PnMagalhaes/uRato_Minotauro/Poster/escorpiao.jpg

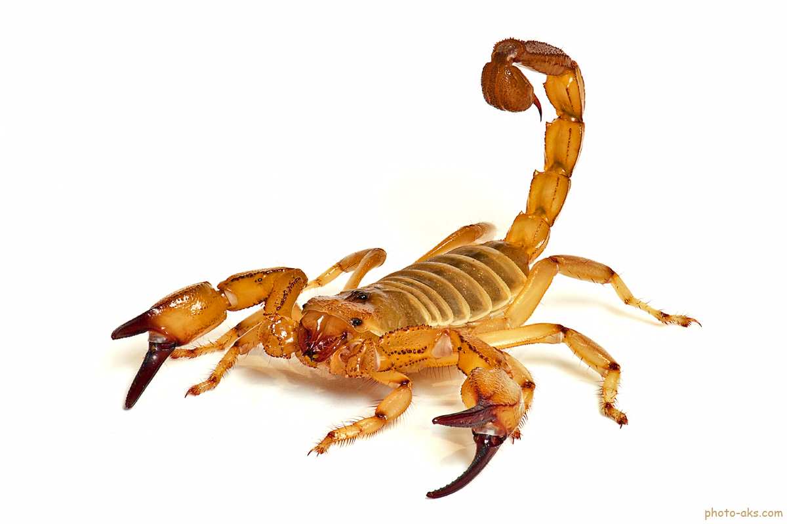
Poster/escorpiao.jpg
