PnMagalhaes/uRato_Minotauro/Gallery/IMG_20180509_173940.jpg

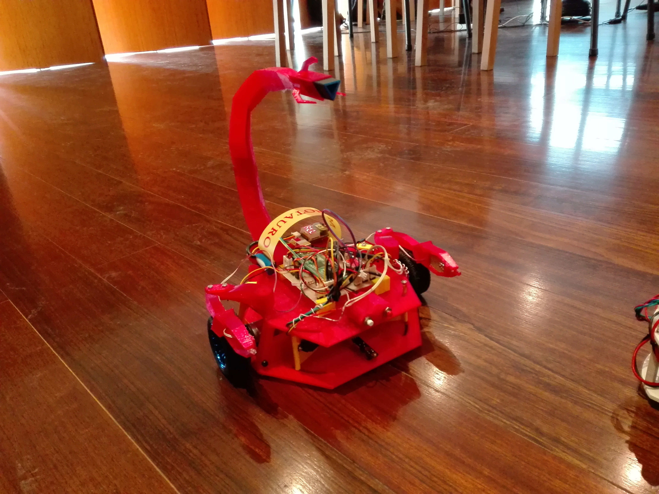
Gallery/IMG_20180509_173940.jpg
