PnMagalhaes/uRato_Minotauro/README.md

# uRato_Minotauro
Maze runner competition
