PnMagalhaes/uRato_Minotauro/CAD/servo/Servo S05NF.JPG

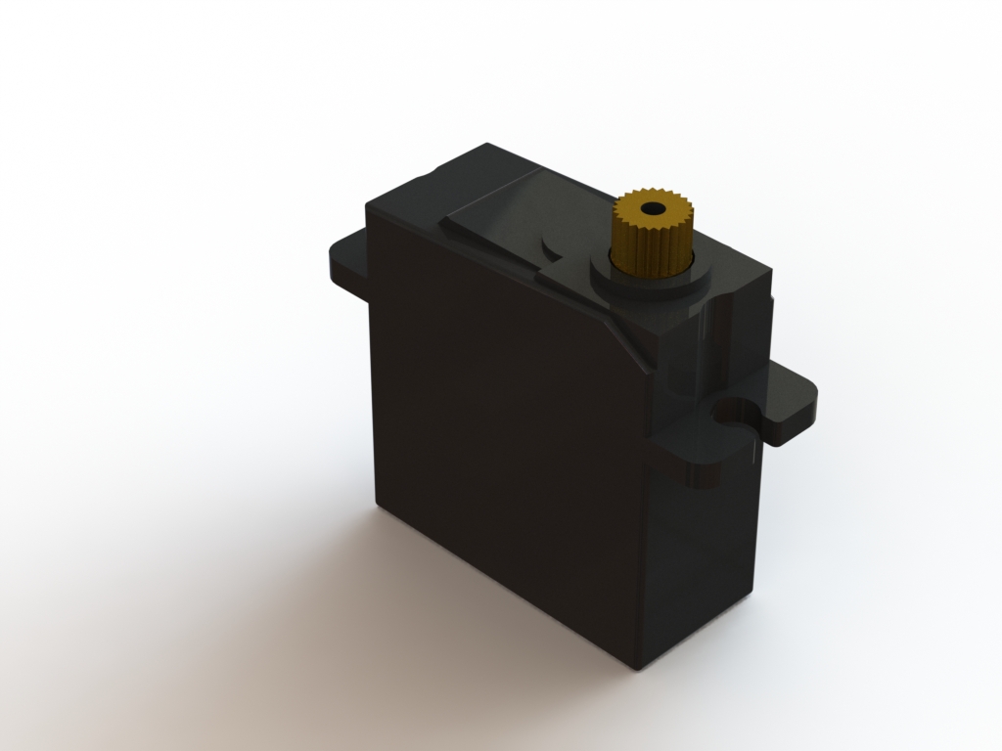
CAD/servo/Servo S05NF.JPG
