PnMagalhaes/uRato_Minotauro/CAD/wheel-with-tire/Renderings/tyre.JPG

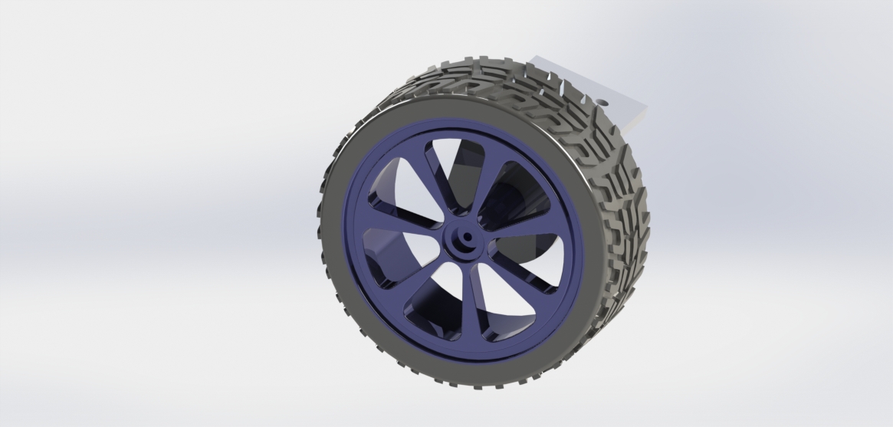
CAD/wheel-with-tire/Renderings/tyre.JPG
