PnMagalhaes/uRato_Minotauro/CAD/wheel-with-tire/Renderings/Wheel_With_Motor.png

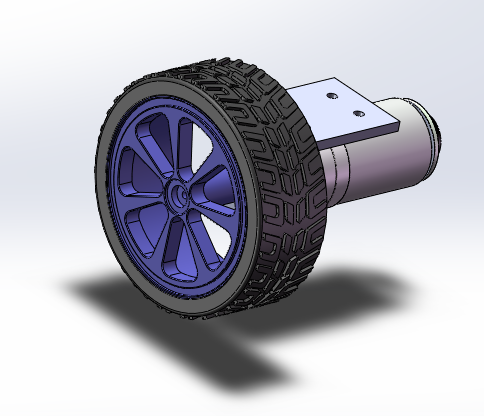
CAD/wheel-with-tire/Renderings/Wheel_With_Motor.png
