PnMagalhaes/uRato_Minotauro/Poster/brain.png

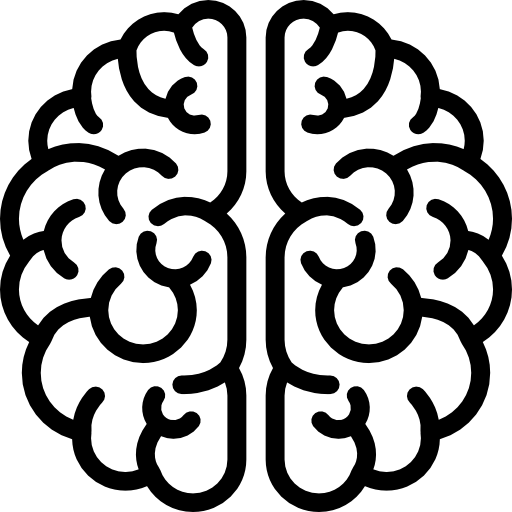
Poster/brain.png
