PnMagalhaes/uRato_Minotauro/Poster/integrated-circuit.png

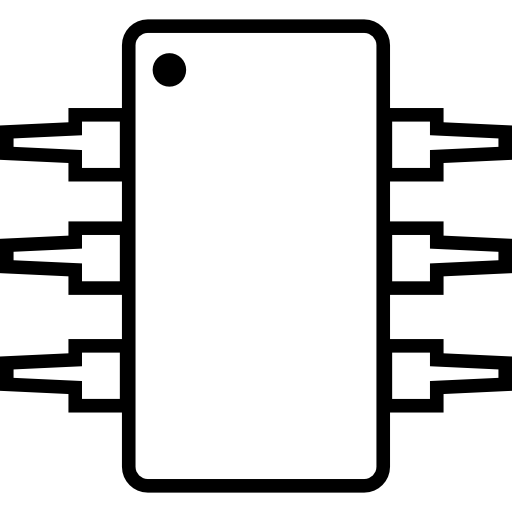
Poster/integrated-circuit.png
