PnMagalhaes/uRato_Minotauro/Poster/square-grid.png

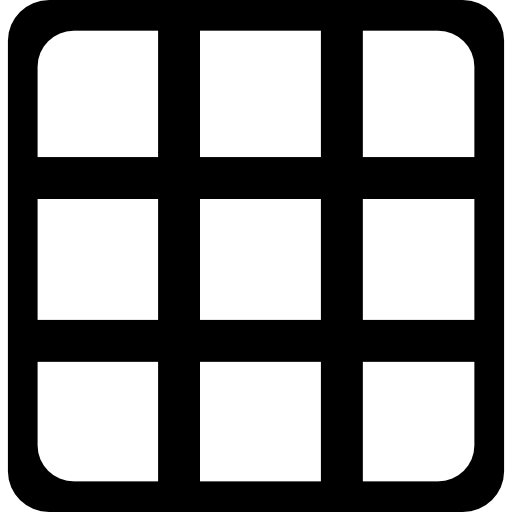
Poster/square-grid.png
