PnMagalhaes/uRato_Minotauro/Poster/wind-rose.png

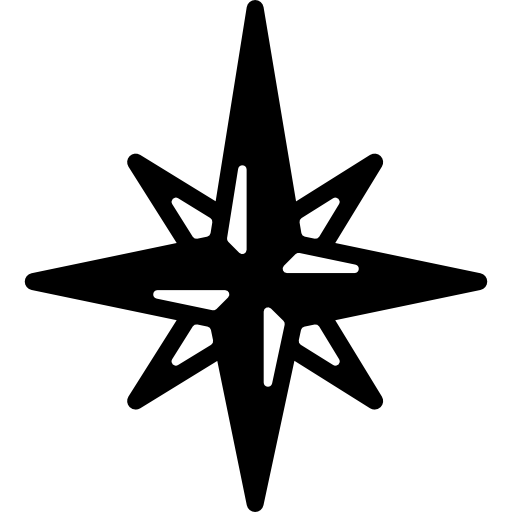
Poster/wind-rose.png
