PnMagalhaes/uRato_Minotauro/CAD/Assem1.SLDASM

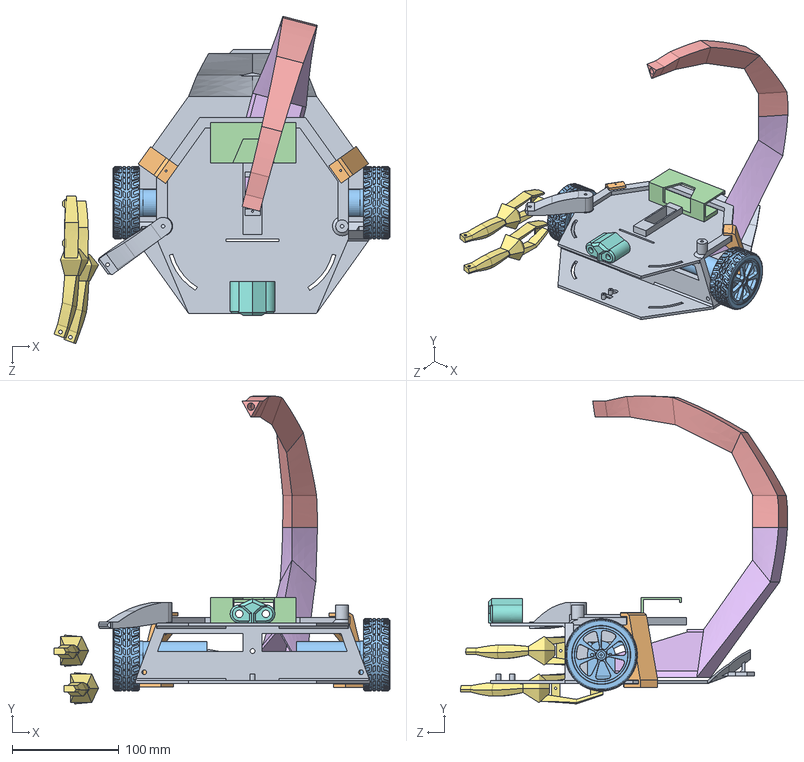
[picture p10: CAD file, 2018-05-11]
CAD/Assem1.SLDASM
315.4 x 289.0 x 307.3 mm
Base
base_reforço x 2
Ass_Motor x 2
bat_holder
cauda_1
Cauda_2
garra x 2
head
patinha
