PnMagalhaes/uRato_Minotauro/CAD/wheel-with-tire/Renderings/Wheel Assemble.SLDASM

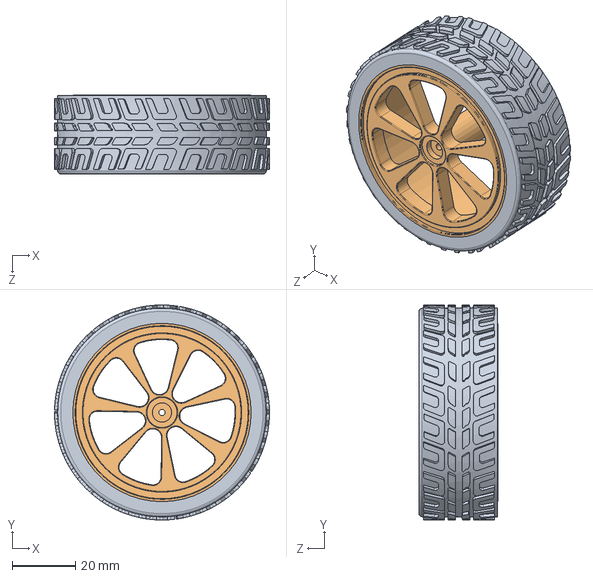
[picture p11: CAD file, 2018-05-04]
CAD/wheel-with-tire/Renderings/Wheel Assemble.SLDASM
68.0 x 68.0 x 25.0 mm
Tire
WheelFrame
