PnMagalhaes/uRato_Minotauro/CAD/Total.SLDASM

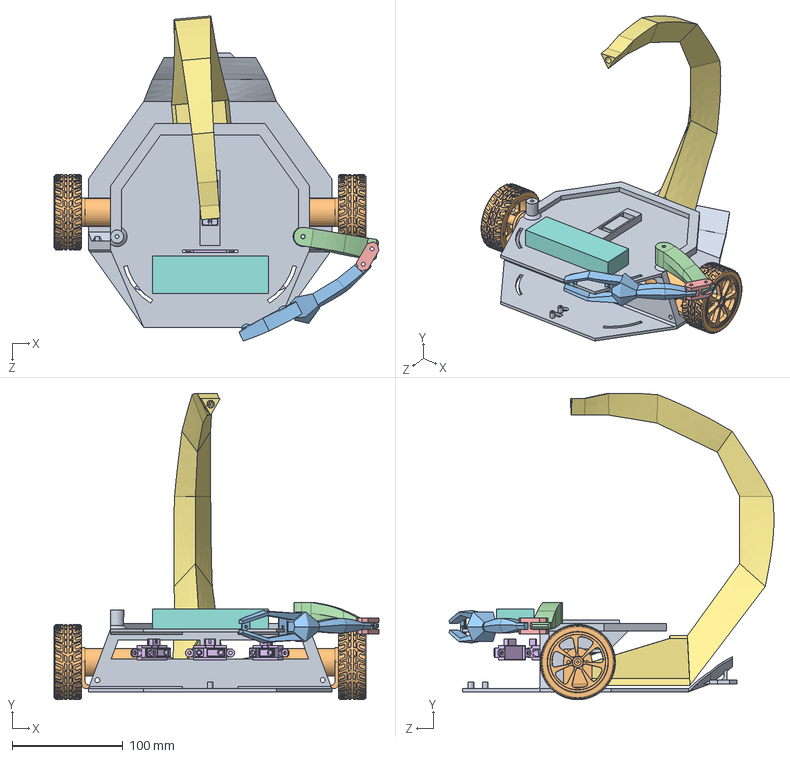
[picture p12: CAD file, 2018-05-04]
CAD/Total.SLDASM
293.6 x 276.9 x 293.7 mm
Base
Ass_Motor x 2
garra
patinha
união
Long Range SHARP IR Sensors - #GP2Y0A21YK0F x 3
cauda
bateria
Servo S05NF
