PnMagalhaes/uRato_Minotauro/CAD/Ass_cauda.SLDASM

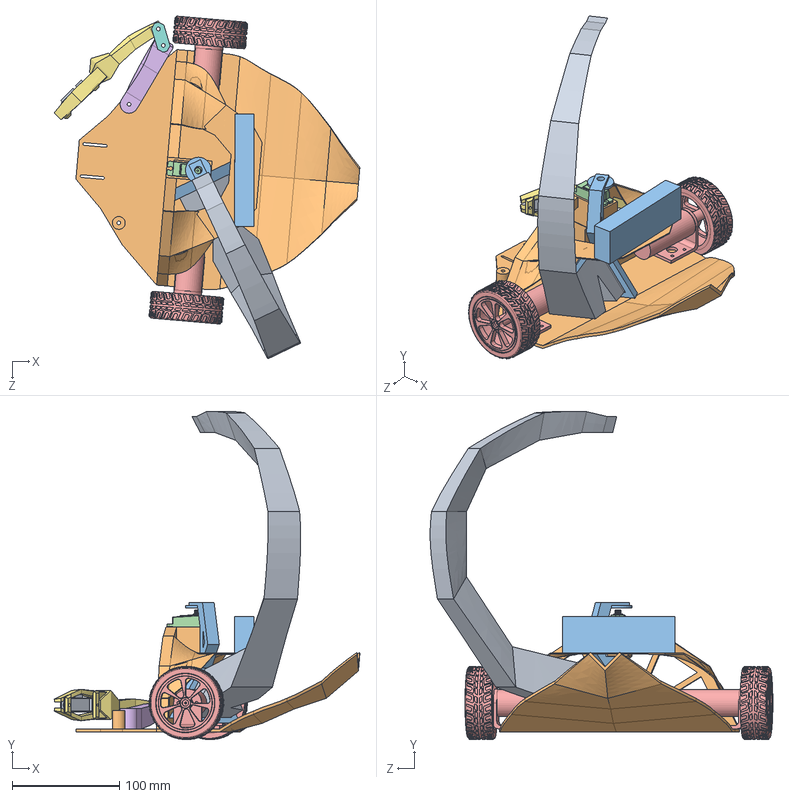
[picture p13: CAD file, 2018-05-04]
CAD/Ass_cauda.SLDASM
284.5 x 305.2 x 318.9 mm
cauda
cauda_3
cauda_encaixe
Servo S05NF
Ass_Motor x 2
patinha
garra
união
Long Range SHARP IR Sensors - #GP2Y0A21YK0F
topcoverback
bateria
