PnMagalhaes/uRato_Minotauro/CAD/Assem2.SLDASM

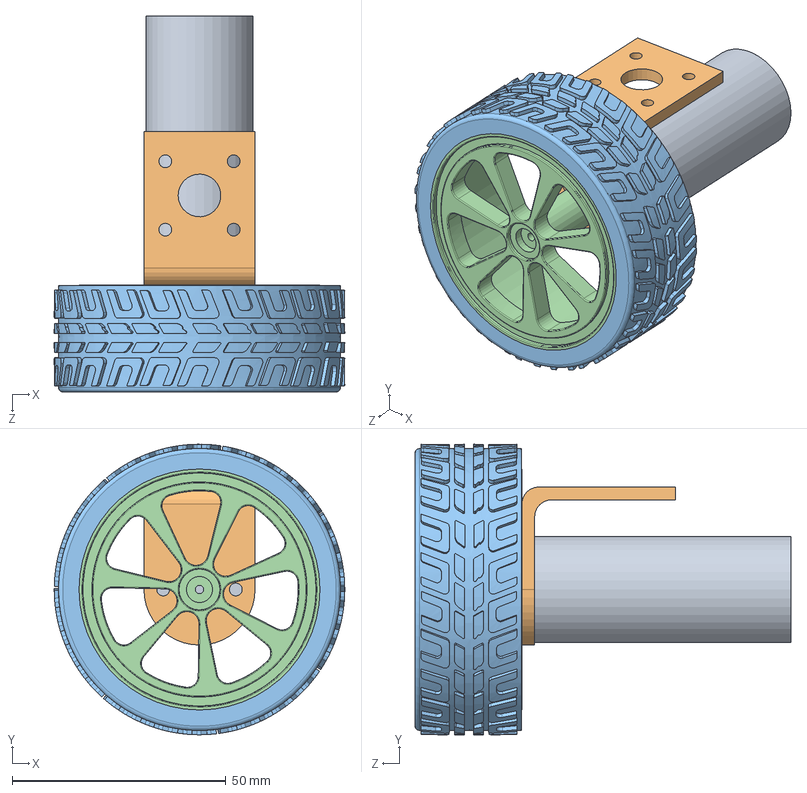
[picture p14: CAD file, 2018-05-04]
CAD/Assem2.SLDASM
68.0 x 68.0 x 88.0 mm
motor
bracket
Tire
WheelFrame
