PnMagalhaes/uRato_Minotauro/CAD/_STL/base_reforco.STL

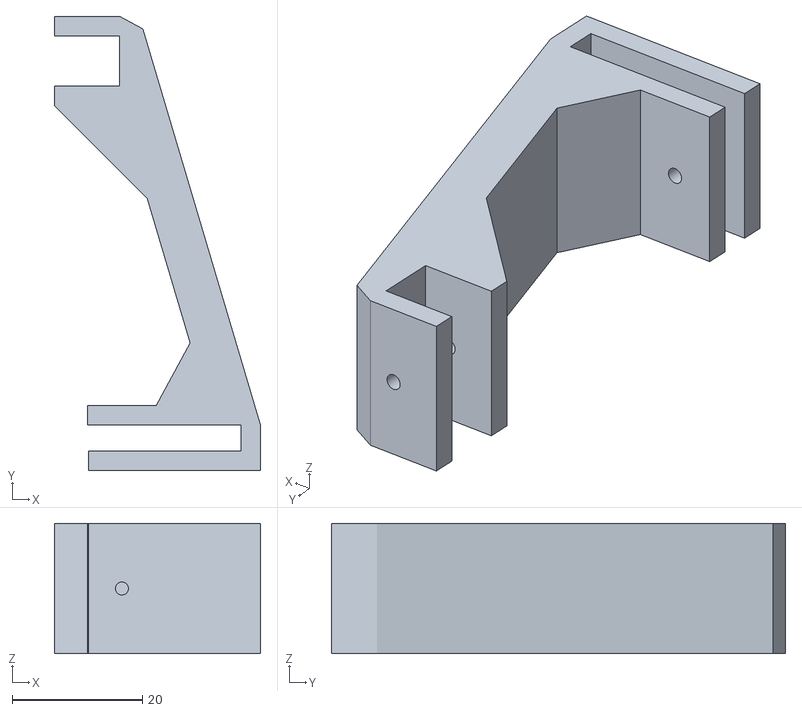
[picture p15: CAD file, 2018-05-11]
CAD/_STL/base_reforco.STL
31.6 x 69.7 x 20.0
