PnMagalhaes/uRato_Minotauro/CAD/wheel-with-tire/motor.SLDPRT

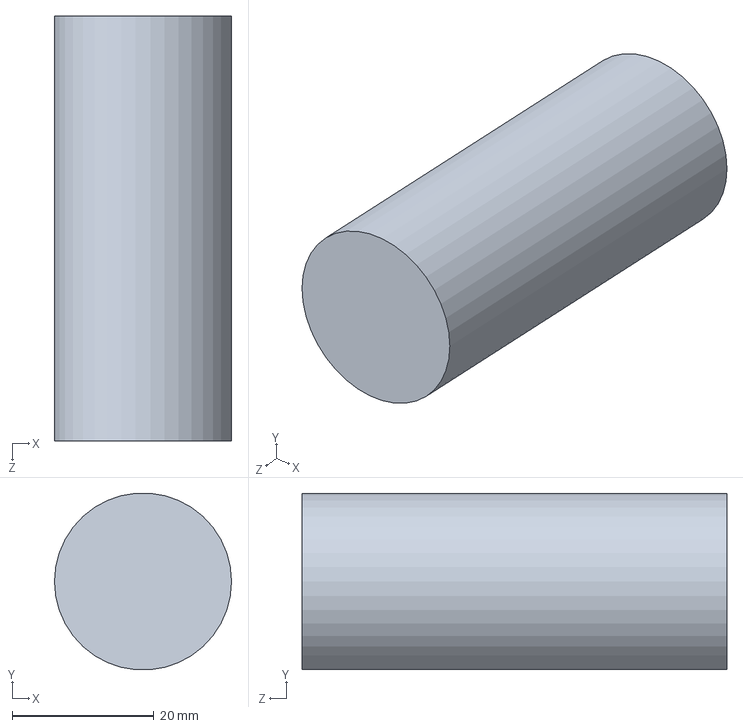
[picture p16: CAD file, 2018-05-04]
CAD/wheel-with-tire/motor.SLDPRT
25.0 x 24.9 x 60.0 mm
