PnMagalhaes/uRato_Minotauro/CAD/wheel-with-tire/Renderings/bracket.SLDPRT

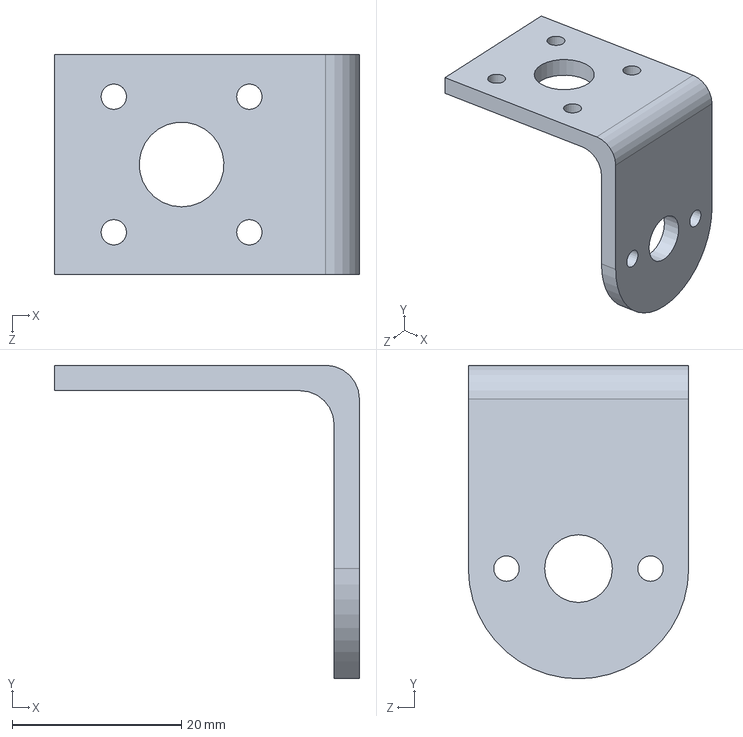
[picture p17: CAD file, 2018-05-04]
CAD/wheel-with-tire/Renderings/bracket.SLDPRT
36.0 x 37.0 x 26.0 mm
