PnMagalhaes/uRato_Minotauro/CAD/_STL/cauda_anilha2.STL

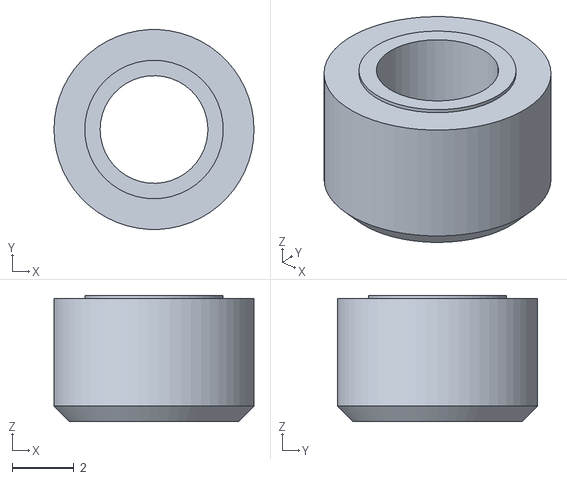
[picture p18: CAD file, 2018-05-04]
CAD/_STL/cauda_anilha2.STL
6.50 x 6.49 x 4.10
