PnMagalhaes/uRato_Minotauro/CAD/_STL/base_tras.sldprt

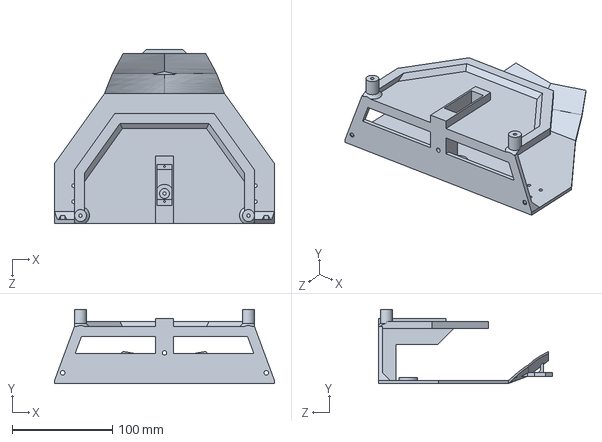
[picture p19: CAD file, 2018-05-04]
CAD/_STL/base_tras.sldprt
220.0 x 74.0 x 174.1 mm
