PnMagalhaes/uRato_Minotauro/CAD/cauda_join.SLDPRT

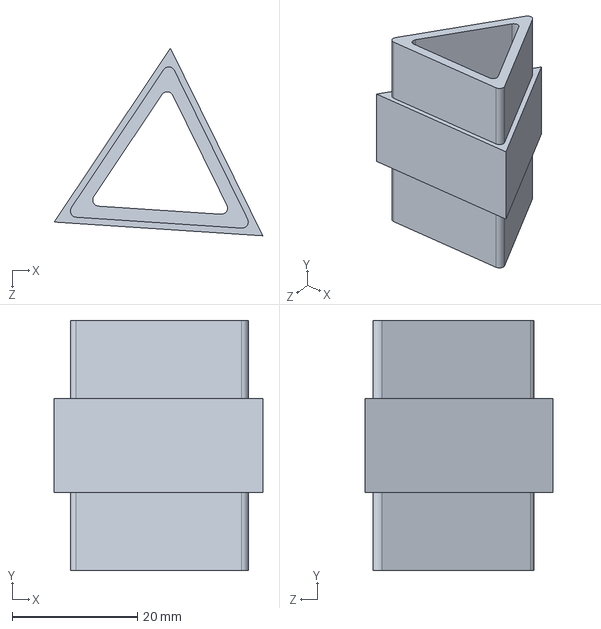
[picture p20: CAD file, 2018-05-11]
CAD/cauda_join.SLDPRT
33.4 x 40.0 x 30.0 mm
