PnMagalhaes/uRato_Minotauro/CAD/wheel-with-tire/Renderings/Tire.SLDPRT

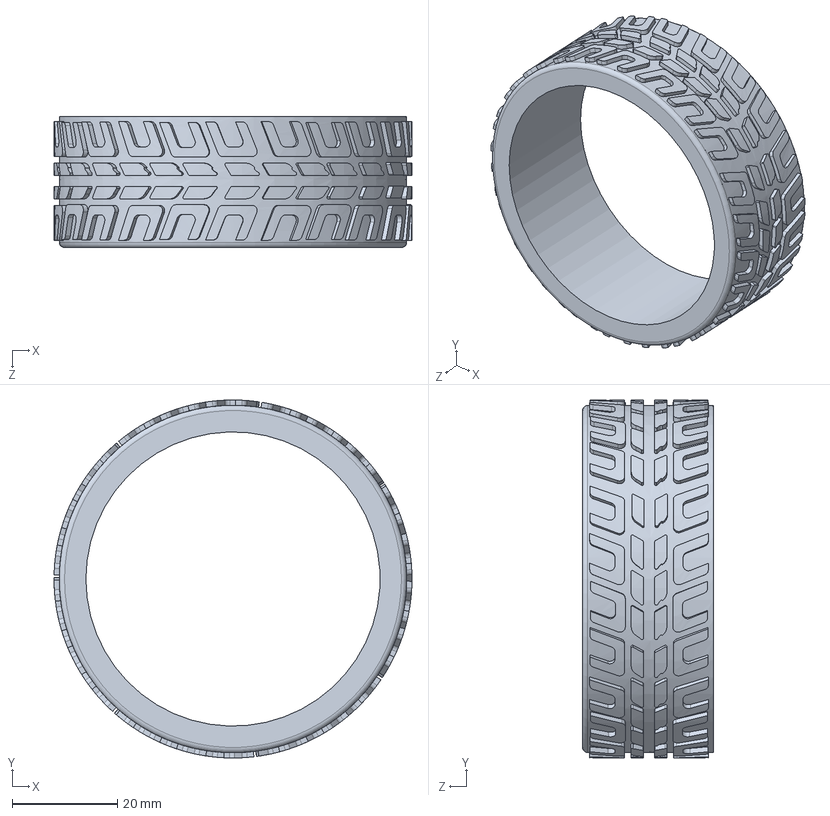
[picture p21: CAD file, 2018-05-04]
CAD/wheel-with-tire/Renderings/Tire.SLDPRT
68.0 x 68.0 x 24.9 mm
