PnMagalhaes/uRato_Minotauro/CAD/lapide.SLDPRT

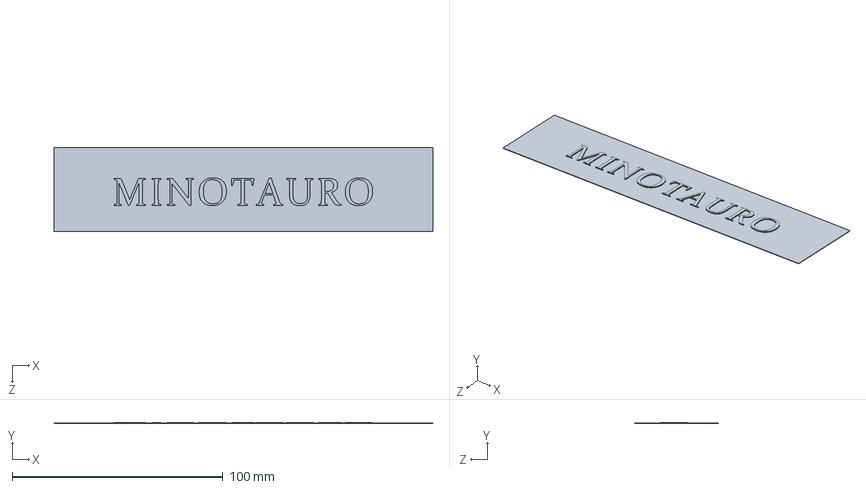
[picture p22: CAD file, 2018-05-11]
CAD/lapide.SLDPRT
180.0 x 0.6 x 40.0 mm
