PnMagalhaes/uRato_Minotauro/CAD/wheel-with-tire/Renderings/MotorBracket.SLDPRT

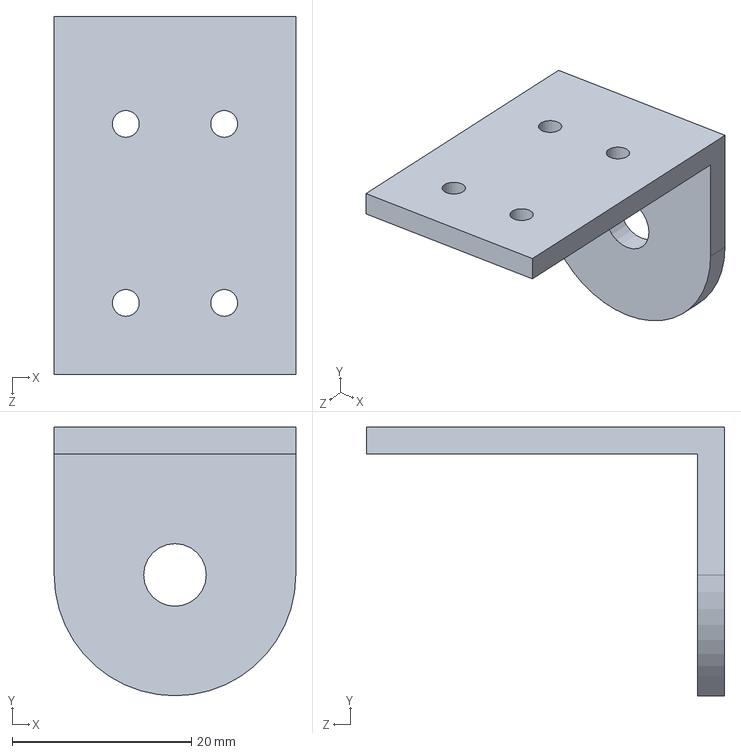
[picture p23: CAD file, 2018-05-04]
CAD/wheel-with-tire/Renderings/MotorBracket.SLDPRT
27.0 x 30.0 x 40.0 mm
