PnMagalhaes/uRato_Minotauro/CAD/_STL/Sharp_meio2.STL

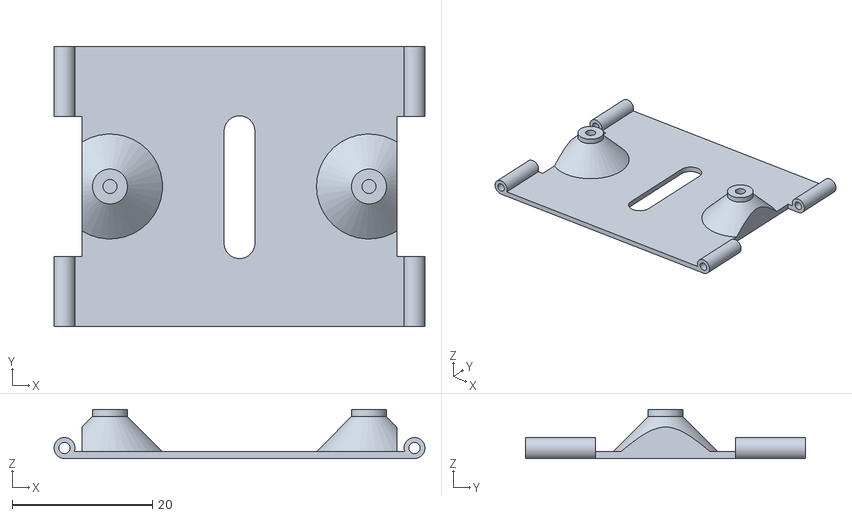
[picture p24: CAD file, 2018-05-04]
CAD/_STL/Sharp_meio2.STL
53.0 x 40.0 x 7.00
