PnMagalhaes/uRato_Minotauro/CAD/bat_holder.SLDPRT

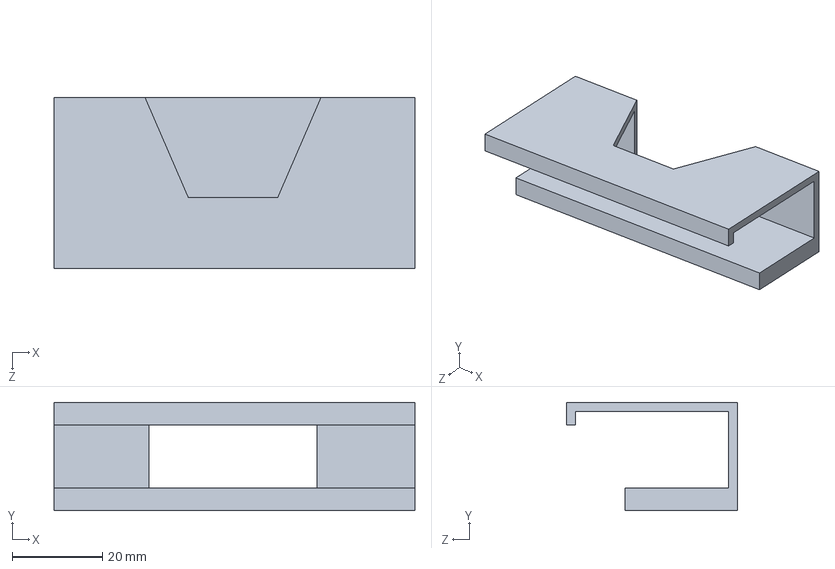
[picture p25: CAD file, 2018-05-11]
CAD/bat_holder.SLDPRT
80.0 x 24.0 x 38.0 mm
