PnMagalhaes/uRato_Minotauro/CAD/wheel-with-tire/Renderings/WheelFrame.SLDPRT

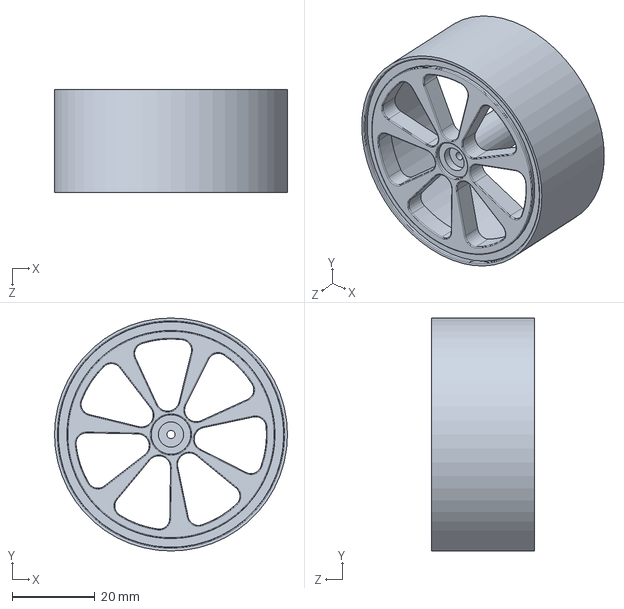
[picture p26: CAD file, 2018-05-04]
CAD/wheel-with-tire/Renderings/WheelFrame.SLDPRT
56.4 x 56.4 x 25.0 mm
