PnMagalhaes/uRato_Minotauro/CAD/pinca.SLDPRT

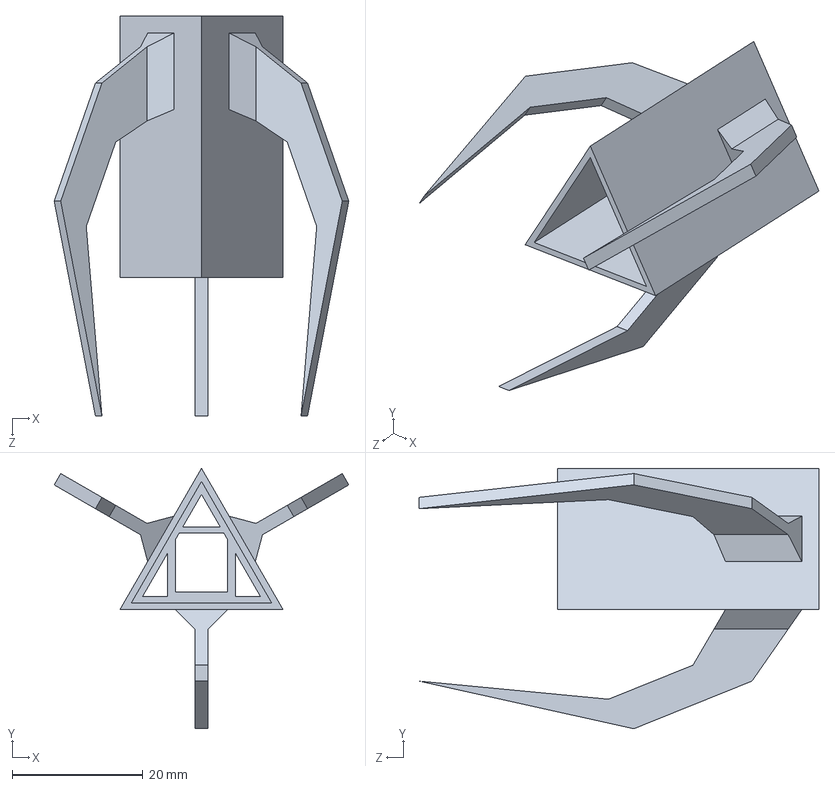
[picture p27: CAD file, 2018-05-11]
CAD/pinca.SLDPRT
45.0 x 39.8 x 61.2 mm
