PnMagalhaes/uRato_Minotauro/CAD/_STL/patinha_esq.SLDPRT

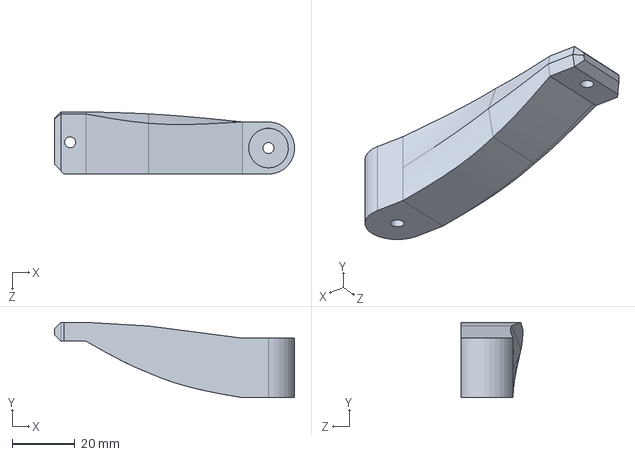
[picture p28: CAD file, 2018-05-04]
CAD/_STL/patinha_esq.SLDPRT
76.7 x 24.1 x 19.9 mm
