PnMagalhaes/uRato_Minotauro/CAD/união.SLDPRT

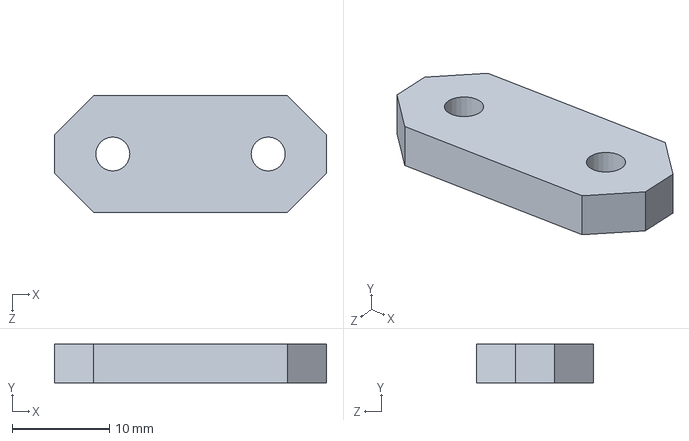
[picture p29: CAD file, 2018-05-11]
CAD/união.SLDPRT
28.0 x 4.00 x 12.0 mm
