PnMagalhaes/uRato_Minotauro/CAD/black_tube.SLDPRT

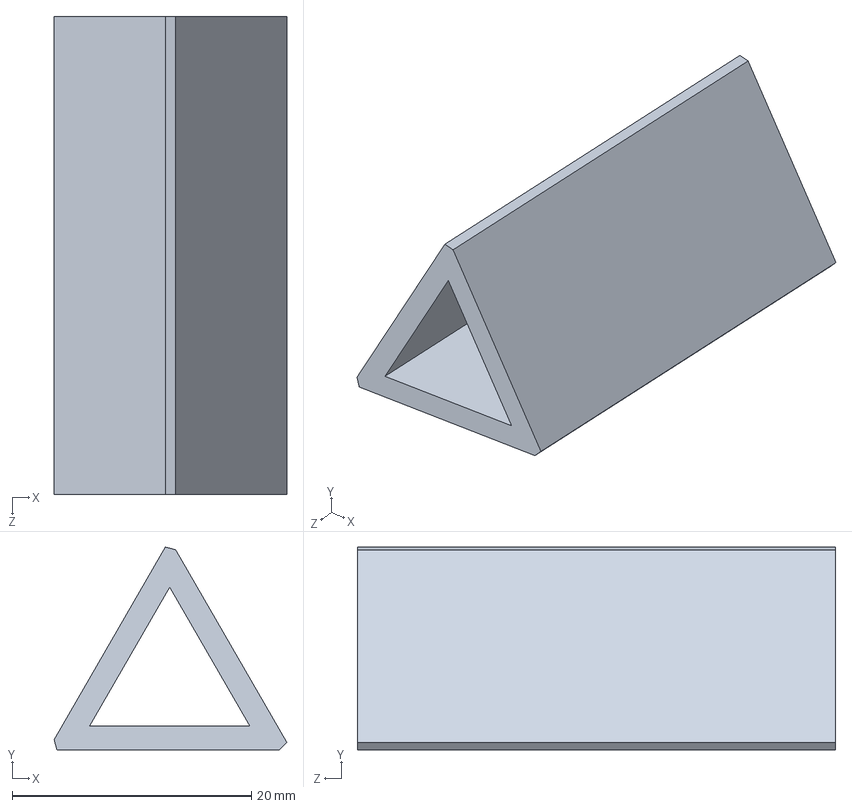
[picture p30: CAD file, 2018-05-11]
CAD/black_tube.SLDPRT
19.5 x 17.0 x 40.0 mm
