PnMagalhaes/uRato_Minotauro/CAD/head.SLDPRT

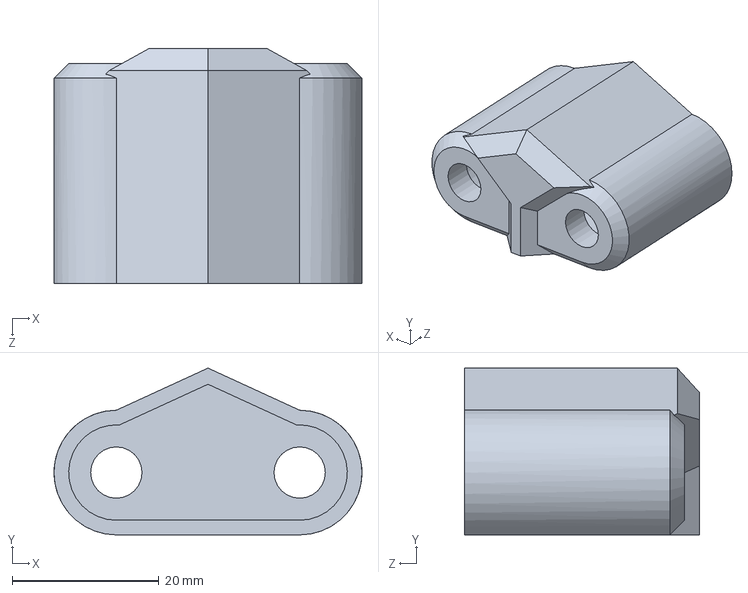
[picture p31: CAD file, 2018-05-11]
CAD/head.SLDPRT
42.0 x 22.7 x 32.0 mm
