PnMagalhaes/uRato_Minotauro/CAD/Sharp_side.SLDPRT

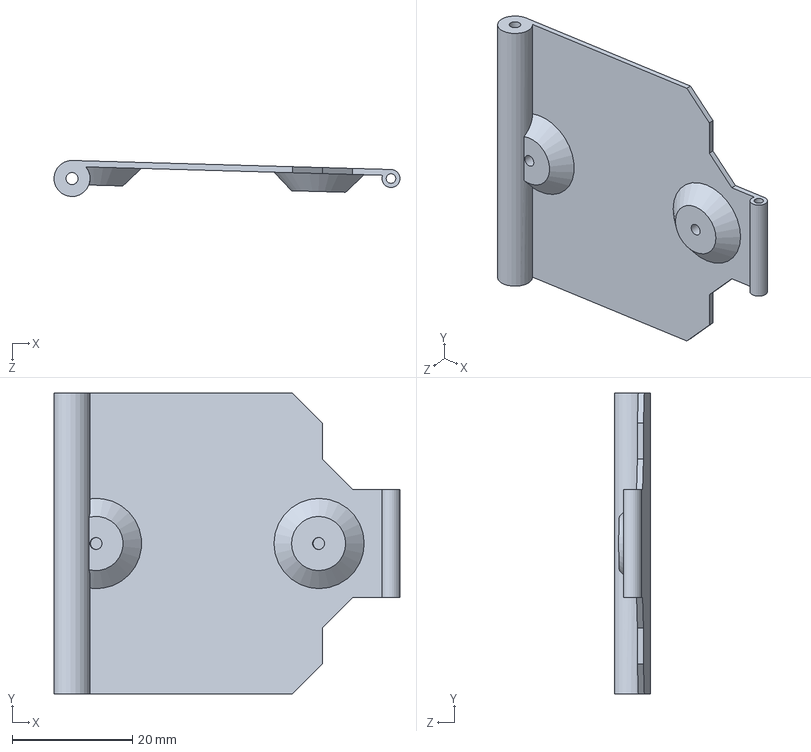
[picture p32: CAD file, 2018-05-04]
CAD/Sharp_side.SLDPRT
57.5 x 50.0 x 5.99 mm
