PnMagalhaes/uRato_Minotauro/CAD/Base.SLDPRT

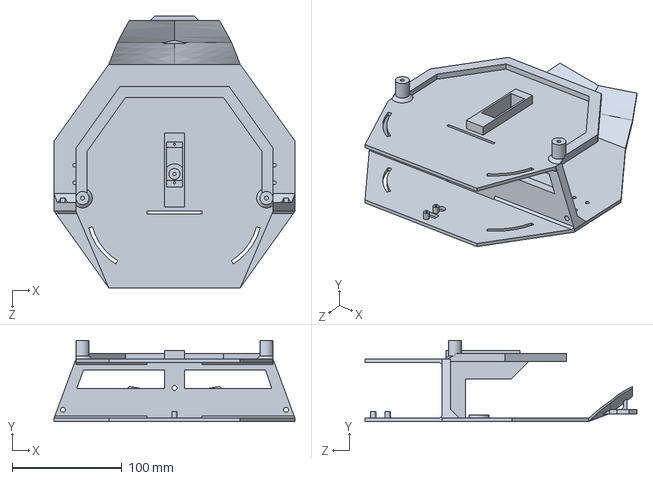
[picture p33: CAD file, 2018-05-04]
CAD/Base.SLDPRT
220.0 x 74.0 x 248.1 mm
