PnMagalhaes/uRato_Minotauro/CAD/Cauda_2.sldprt

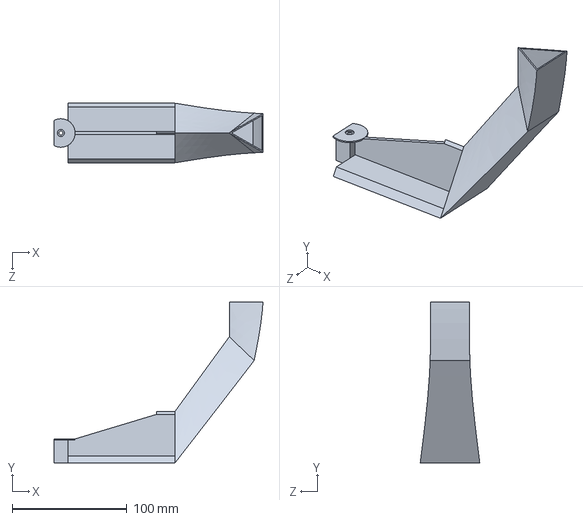
[picture p34: CAD file, 2018-05-04]
CAD/Cauda_2.sldprt
182.3 x 140.4 x 52.0 mm
