PnMagalhaes/uRato_Minotauro/CAD/Sharp_meio.SLDPRT

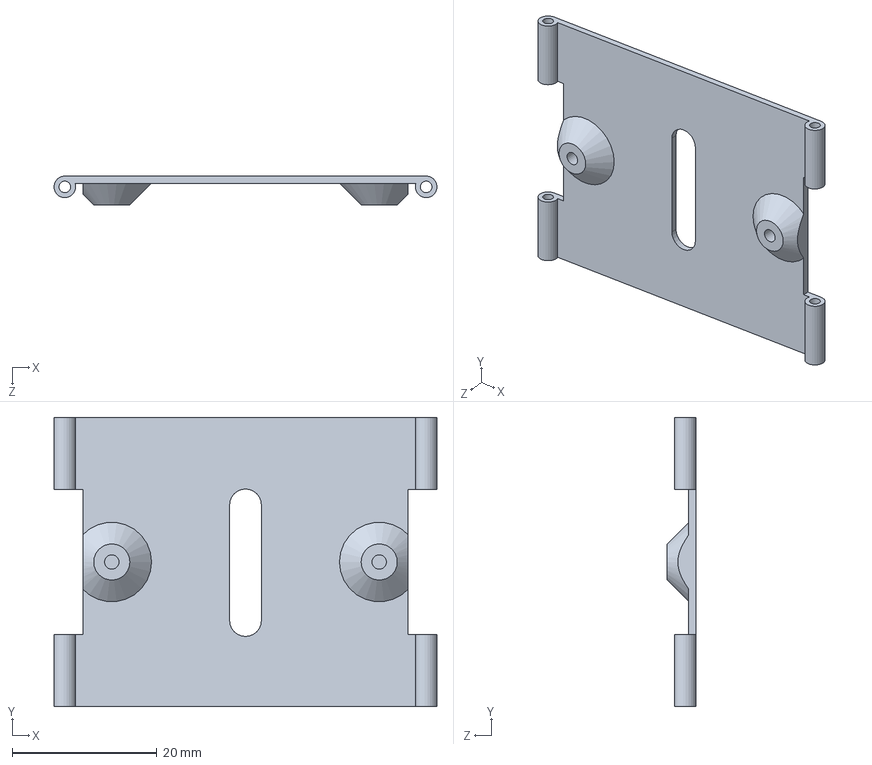
[picture p35: CAD file, 2018-05-04]
CAD/Sharp_meio.SLDPRT
53.0 x 40.0 x 4.00 mm
