PnMagalhaes/uRato_Minotauro/CAD/garra.SLDPRT

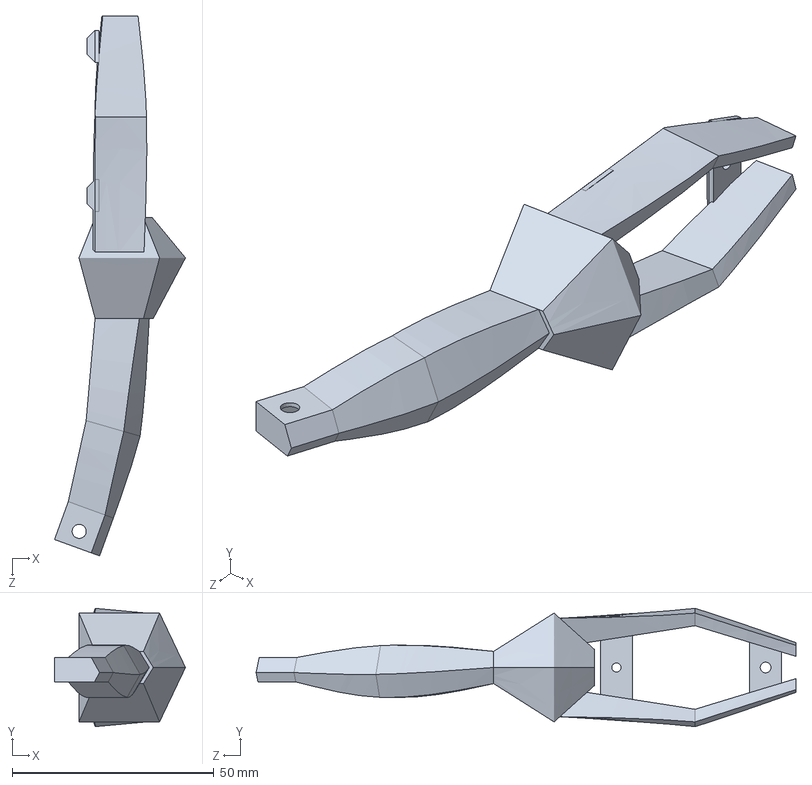
[picture p36: CAD file, 2018-05-04]
CAD/garra.SLDPRT
32.5 x 29.3 x 133.9 mm
