PnMagalhaes/uRato_Minotauro/CAD/cauda_1.sldprt

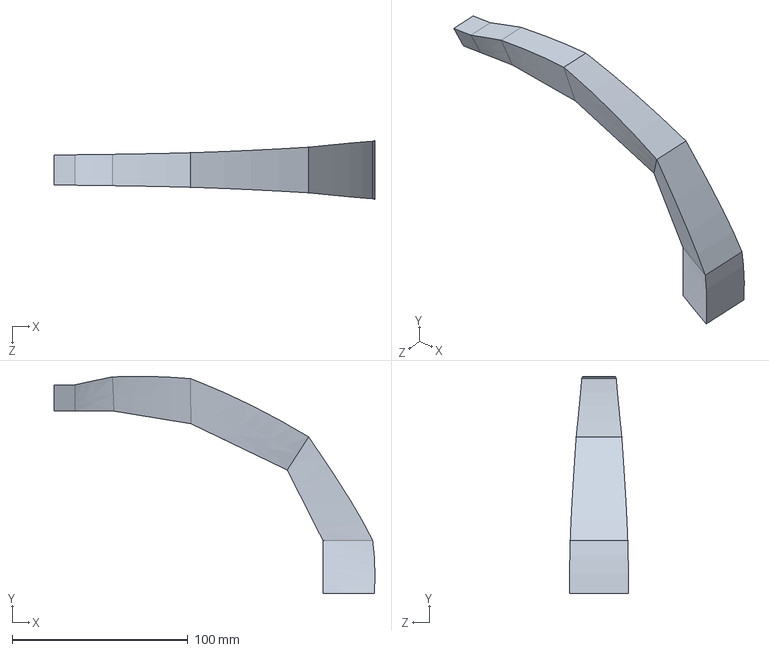
[picture p37: CAD file, 2018-05-04]
CAD/cauda_1.sldprt
182.6 x 123.6 x 33.7 mm
