PnMagalhaes/uRato_Minotauro/(list of files, cad)

Other CAD files:
CAD/servo/Servo S05NF.SLDPRT
CAD/sharp-ir-sensor/Long Range SHARP IR Sensors - #GP2Y0A21YK0F.SLDPRT
CAD/base_reforço.SLDPRT
CAD/_STL/base_frente.sldprt
CAD/_STL/base_tras2.STL
CAD/_STL/patinha.SLDPRT
CAD/uniãov2.SLDPRT
CAD/Ass_Motor.SLDPRT
CAD/cauda.SLDPRT
CAD/bateria.SLDPRT
CAD/PCB.SLDPRT
CAD/cauda_anilha.SLDPRT
CAD/_STL/Cauda_2.STL
CAD/_STL/Sharp_meio.STL
CAD/_STL/Sharp_side.STL
CAD/_STL/base_frente.STL
CAD/_STL/base_tras.STL
CAD/_STL/bat_holder.STL
CAD/_STL/black_tube.STL
CAD/_STL/cauda_1.STL
CAD/_STL/cauda_anilha.STL
CAD/_STL/cauda_join.STL
CAD/_STL/garra.STL
CAD/_STL/head.STL
CAD/_STL/lapide.STL
CAD/_STL/patinha.STL
CAD/_STL/patinha_esq.STL
CAD/_STL/pinca.STL
CAD/_STL/união.STL
CAD/_STL/uniãov2.STL
CAD/patinha.SLDPRT
