PnMagalhaes/uRato_Minotauro/Schematic.brd

## EAGLE design Schematic.brd (2018-05-08)

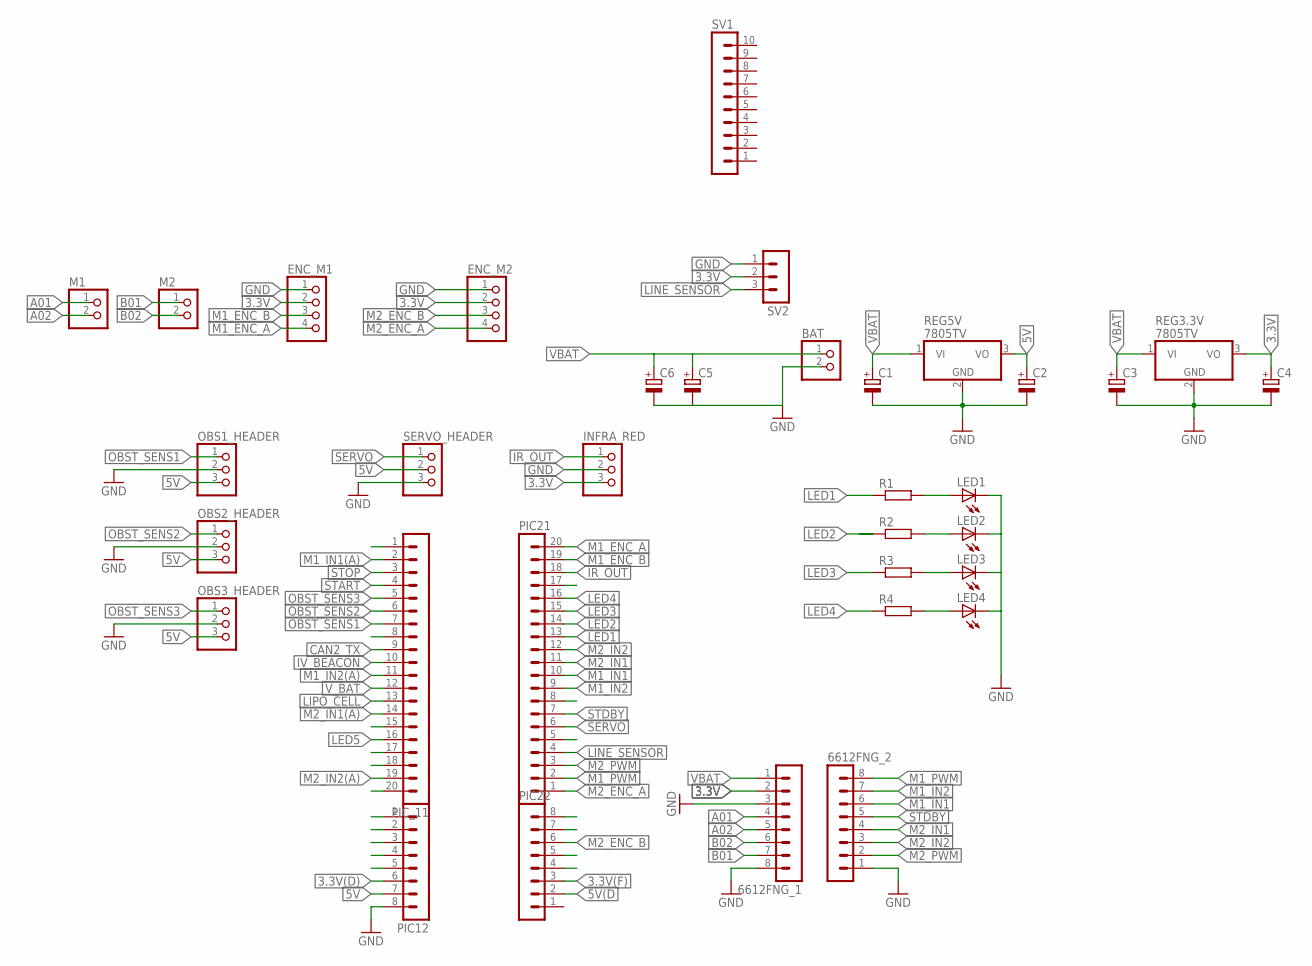
[picture p38: schematic Schematic.sch]

Parts:
6612FNG_1, 6612FNG_2: MA08-1
BAT: PINHD-1X2; 1X02
C1, C2, C3, C4, C5, C6: CPOL-EUE2,5-6E; E2,5-6E
ENC_M1, ENC_M2: PINHD-1X4; 1X04
INFRA_RED: PINHD-1X3; 1X03
LED1, LED2, LED3, LED4: LED3MM
M1, M2: PINHD-1X2; 1X02
OBS1_HEADER, OBS2_HEADER, OBS3_HEADER: PINHD-1X3; 1X03
PIC12, PIC22: MA08-1
PIC21: MA20-1
PIC_11: MA20-1
R1, R2, R3, R4: R-EU_0207/7; 0207/7
REG3.3V, REG5V: 7805TV; TO220V
SERVO_HEADER: PINHD-1X3; 1X03
SV1: MA10-1
SV2: MA03-1

Connections:
3.3V: 6612FNG_1.2, C4.+, ENC_M1.2, ENC_M2.2, INFRA_RED.3, REG3.3V.3 (VO), SV2.2
3.3V(D): PIC12.6
3.3V(F): PIC22.3
5V: C2.+, OBS1_HEADER.3, OBS2_HEADER.3, OBS3_HEADER.3, PIC12.7, REG5V.3 (VO), SERVO_HEADER.2
5V(D: PIC22.2
A01: 6612FNG_1.4, M1.1
A02: 6612FNG_1.5, M1.2
B01: 6612FNG_1.7, M2.1
B02: 6612FNG_1.6, M2.2
CAN1_RX: PIC_11.17
CAN1_TX: PIC_11.18
CAN2_RX: PIC_11.15
CAN2_TX: PIC_11.9
DIR_485: PIC21.17
GND: 6612FNG_1.3, 6612FNG_1.8, 6612FNG_2.1, BAT.2, C1.-, C2.-, C3.-, C4.-, C5.-, C6.-, ENC_M1.1, ENC_M2.1, INFRA_RED.2, LED1.K (C), LED2.K (C), LED3.K (C), LED4.K (C), OBS1_HEADER.2, OBS2_HEADER.2, OBS3_HEADER.2, PIC12.8, REG3.3V.2 (GND), REG5V.2 (GND), SERVO_HEADER.3, SV2.1
I2C_SCL: PIC22.8
I2C_SDA: PIC22.7
IO2_U1TX: PIC21.5
IO4: PIC21.8
IR_OUT: INFRA_RED.1, PIC21.18
IV_BEACON: PIC_11.10
LED1: PIC21.13, R1.1
LED2: PIC21.14, R2.1
LED3: PIC21.15, R3.1
LED4: PIC21.16, R4.1
LED5: PIC_11.16
LINE_SENSOR: PIC21.4, SV2.3
LIPO_CELL: PIC_11.13
M1_ENC_A: ENC_M1.4, PIC21.20
M1_ENC_B: ENC_M1.3, PIC21.19
M1_IN1: 6612FNG_2.6, PIC21.10
M1_IN1(A): PIC_11.2
M1_IN2: 6612FNG_2.7, PIC21.9
M1_IN2(A): PIC_11.11
M1_PWM: 6612FNG_2.8, PIC21.2
M2_ENC_A: ENC_M2.4, PIC21.1
M2_ENC_B: ENC_M2.3, PIC22.6
M2_IN1: 6612FNG_2.4, PIC21.11
M2_IN1(A): PIC_11.14
M2_IN2: 6612FNG_2.3, PIC21.12
M2_IN2(A): PIC_11.19
M2_PWM: 6612FNG_2.2, PIC21.3
unnamed: LED1.A, R1.2
unnamed: LED2.A, R2.2
unnamed: LED3.A, R3.2
unnamed: LED4.A, R4.2
OBST_SENS1: OBS1_HEADER.1, PIC_11.7
OBST_SENS2: OBS2_HEADER.1, PIC_11.6
OBST_SENS3: OBS3_HEADER.1, PIC_11.5
PGC: PIC_11.1
PGD: PIC_11.8
SERVO: PIC21.6, SERVO_HEADER.1
START: PIC_11.4
STDBY: 6612FNG_2.5, PIC21.7
STOP: PIC_11.3
U2_RC: PIC_11.20
U2_TX: PIC12.1
U6_TX: PIC22.4
VBAT: 6612FNG_1.1, BAT.1, C1.+, C3.+, C5.+, C6.+, REG3.3V.1 (VI), REG5V.1 (VI)
V_BAT: PIC_11.12

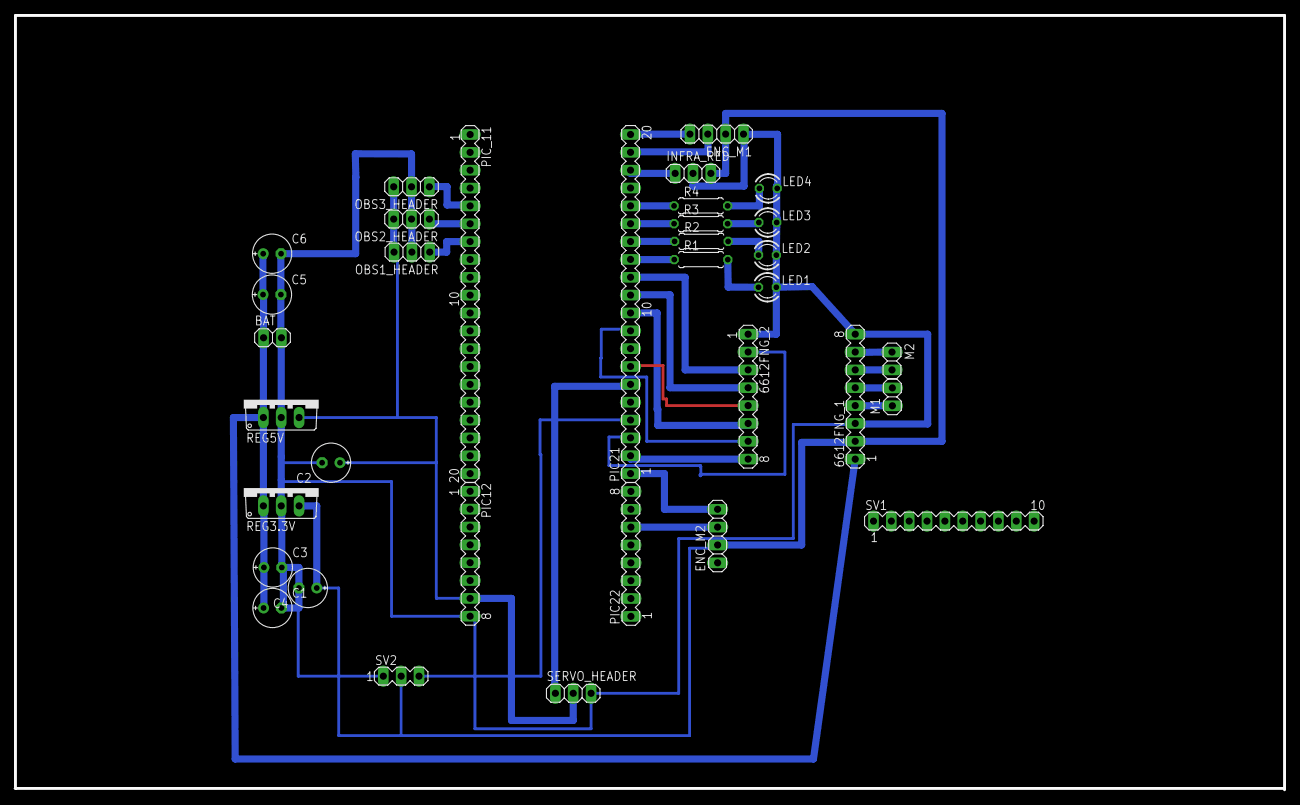
[picture p39: board Schematic.brd from above]

Board: 2 copper layers, 180.6 x 110.0 mm, 34 parts (0 on the bottom side), 33 nets.
