PnMagalhaes/uRato_Minotauro/(commit log)

2018-05-08 Revisão dos pinouts- Beacon, sharp 1 e 3, line sensor a funcionar
2018-05-08 Eagle files
    [Schematic.brd, Schematic.sch]
2018-05-11 New cad files
    [Assem1.SLDASM, base_reforco.STL, base_reforço.SLDPRT, bat_holder.SLDPRT, bat_holder.STL, black_tube.SLDPRT, black_tube.STL, cauda_join.SLDPRT]
